TechBatch/Ad-Hoc-Network-Communication-System-for-Disaster-Relief/POSTER/TECHBatchjpg.jpg

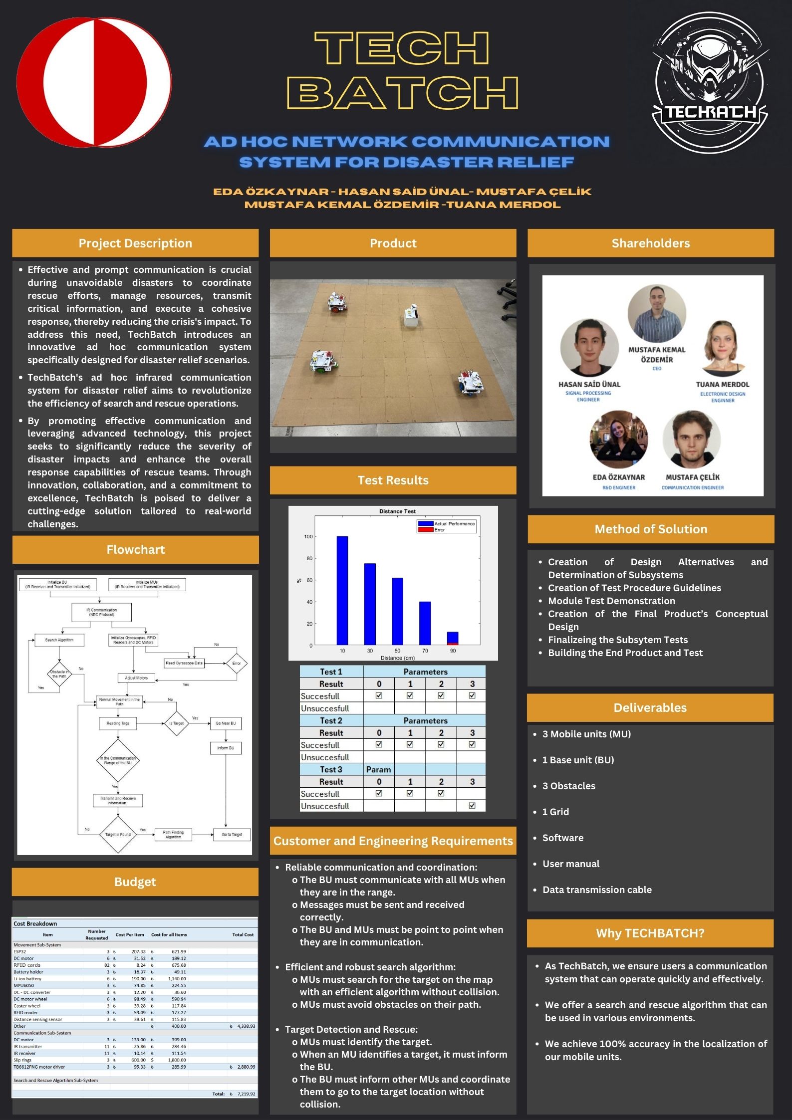
POSTER/TECHBatchjpg.jpg
