TechBatch/Ad-Hoc-Network-Communication-System-for-Disaster-Relief/README.md

# Ad-Hoc-Network-Communication-System-for-Disaster-Relief
TechBatch 2023-24 Capstone Project
