TechBatch/Ad-Hoc-Network-Communication-System-for-Disaster-Relief/Flowcharts of Algorithms/README.md

# Ad-Hoc-Network-Communication-System-for-Disaster-Relief
# Flowcharts of Algorithms
TechBatch 2023-24 Capstone Project
## Link for search algorithm flowchart
https://app.diagrams.net/#G1cPadi86MyawuQ8vJ1zWhPavOyXc6iH4G
  ### TO DO:
  * Add other MU's target info according to code architecture algorithm.
## Link for Grid partitioning
https://app.diagrams.net/#G1-ycmmlxIB4yDz8SyxYrDLsC9prfCw-PL
