TechBatch/Ad-Hoc-Network-Communication-System-for-Disaster-Relief/Presentation/metu_eee_presentation_template.pptx

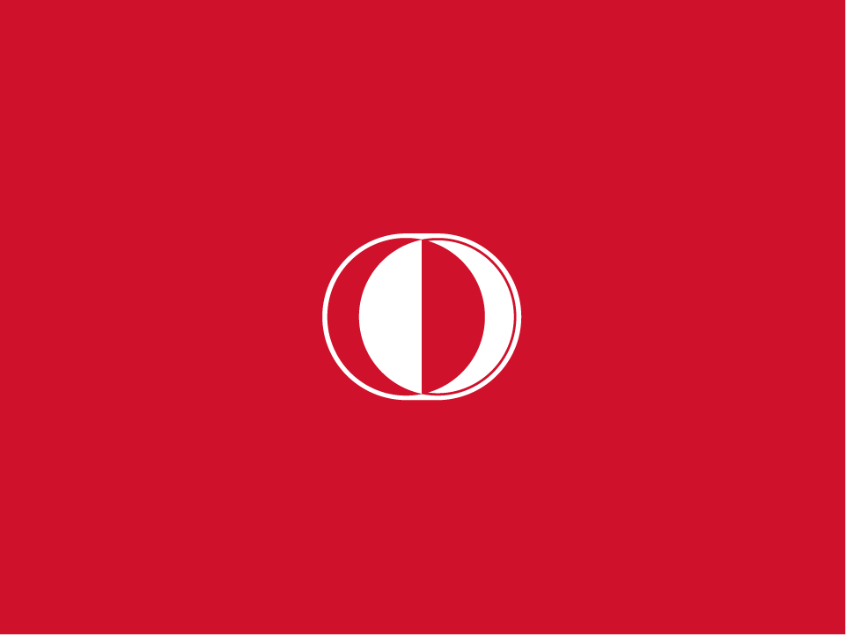
[picture p23: figure]

## Slide 2

## Slide 3

## Slide 4

## Slide 5
