TechBatch/Ad-Hoc-Network-Communication-System-for-Disaster-Relief/POSTER/TECHBatchstdpdf.pdf

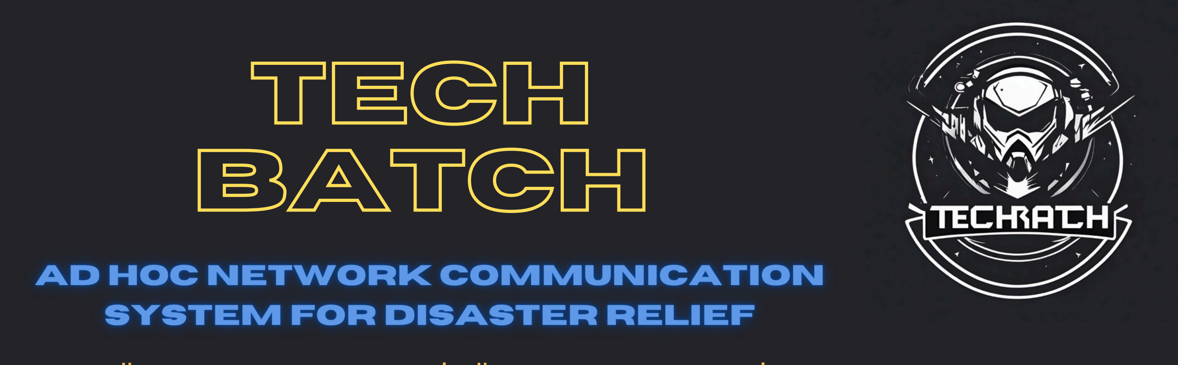
[picture p33: figure]
TECH BATCH

Project Description | Product | Shareholders


### Method of Solution Flowchart


### Budget


### Why TECHBATCH?


### Deliverables

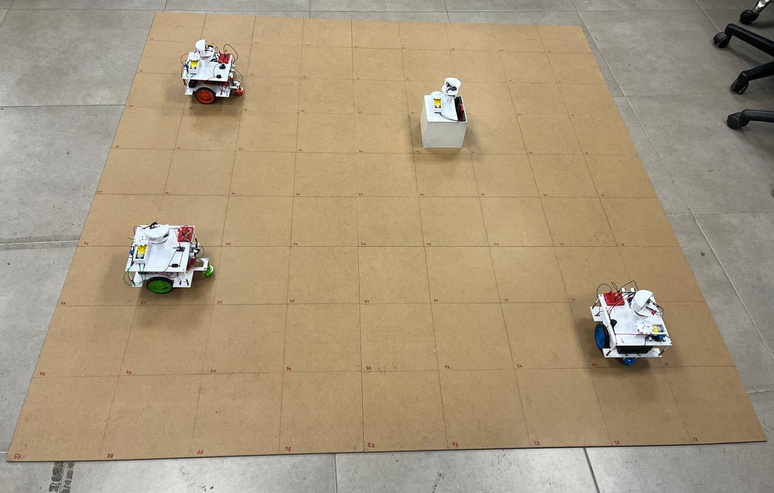
[picture p34: figure]

### Test Results

Customer and Engineering Requirements; Reliable communication and coordination:; they are in the range. o Messages must be sent and received correctly.; they are in communication.; Efficient and robust search algorithm:; Target Detection and Rescue: o MUs must identify the target.; the BU.; collision.

o The BU must communicate with all MUs when

o The BU and MUs must be point to point when

o MUs must search for the target on the map with an efficient algorithm without collision. o MUs must avoid obstacles on their path.

o When an MU identifies a target, it must inform

o The BU must inform other MUs and coordinate them to go to the target location without

EDA ÖZKAYNAR - HASAN SAİD ÜNAL- MUSTAFA ÇELİk mustafa kemal özdemİr -tuanamerdol

Creation | of | Design | Alternatives | and
Determination of Subsystems
Creation of Test Procedure Guidelines
Module Test Demonstration
Creation of the Final Product’s Conceptual Design
Finalizeing the Subsytem Tests
Building the End Product and Test

Effective and prompt communication is crucial during unavoidable disasters to coordinate rescue efforts, manage resources, transmit critical information, and execute a cohesive response, thereby reducing the crisis's impact. To address this need, TechBatch introduces an innovative ad hoc communication system specifically designed for disaster relief scenarios. TechBatch's ad hoc infrared communication system for disaster relief aims to revolutionize the efficiency of search and rescue operations. By promoting effective communication and leveraging advanced technology, this project seeks to significantly reduce the severity of disaster impacts and enhance the overall response capabilities of rescue teams. Through innovation, collaboration, and a commitment to excellence, TechBatch is poised to deliver a cutting-edge solution tailored to real-world challenges.

### 3 Mobile units (MU)

### 1 Base unit (BU)

### 3 Obstacles

### 1 Grid

Software

User manual

Data transmission cable

As TechBatch, we ensure users a communication system that can operate quickly and effectively.

We offer a search and rescue algorithm that can be used in various environments.

We achieve 100% accuracy in the localization of our mobile units.
