TechBatch/Ad-Hoc-Network-Communication-System-for-Disaster-Relief/Flowcharts of Algorithms/code_arcitecture.jpg

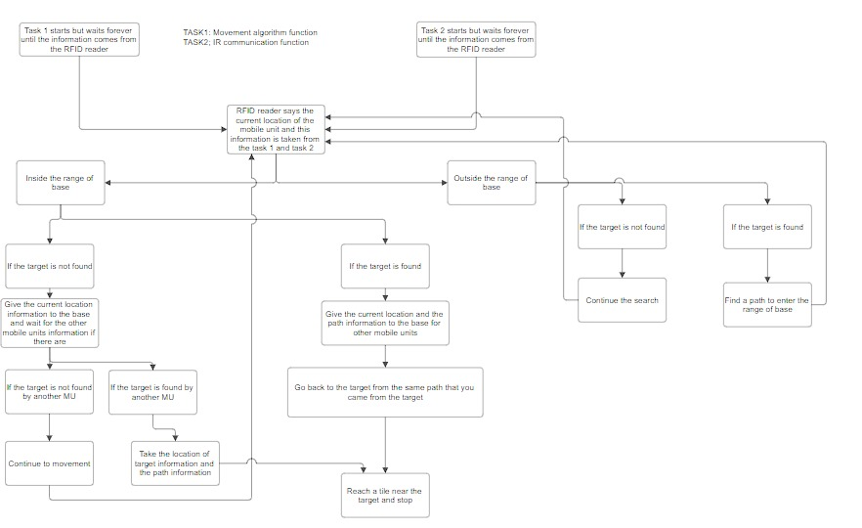
Flowcharts of Algorithms/code_arcitecture.jpg
