TechBatch/Ad-Hoc-Network-Communication-System-for-Disaster-Relief/Flowcharts of Algorithms/SearchAlgorithm.png

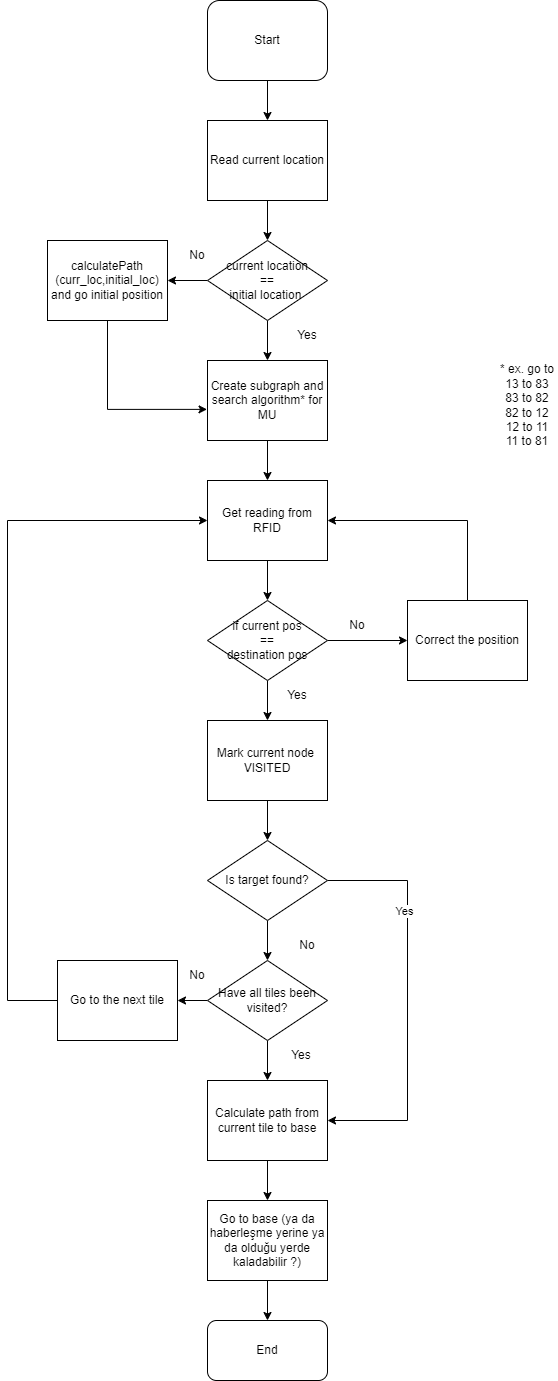
Flowcharts of Algorithms/SearchAlgorithm.png
