TechBatch/Ad-Hoc-Network-Communication-System-for-Disaster-Relief/Flowcharts of Algorithms/SearchAlgorithmFlowChart.png

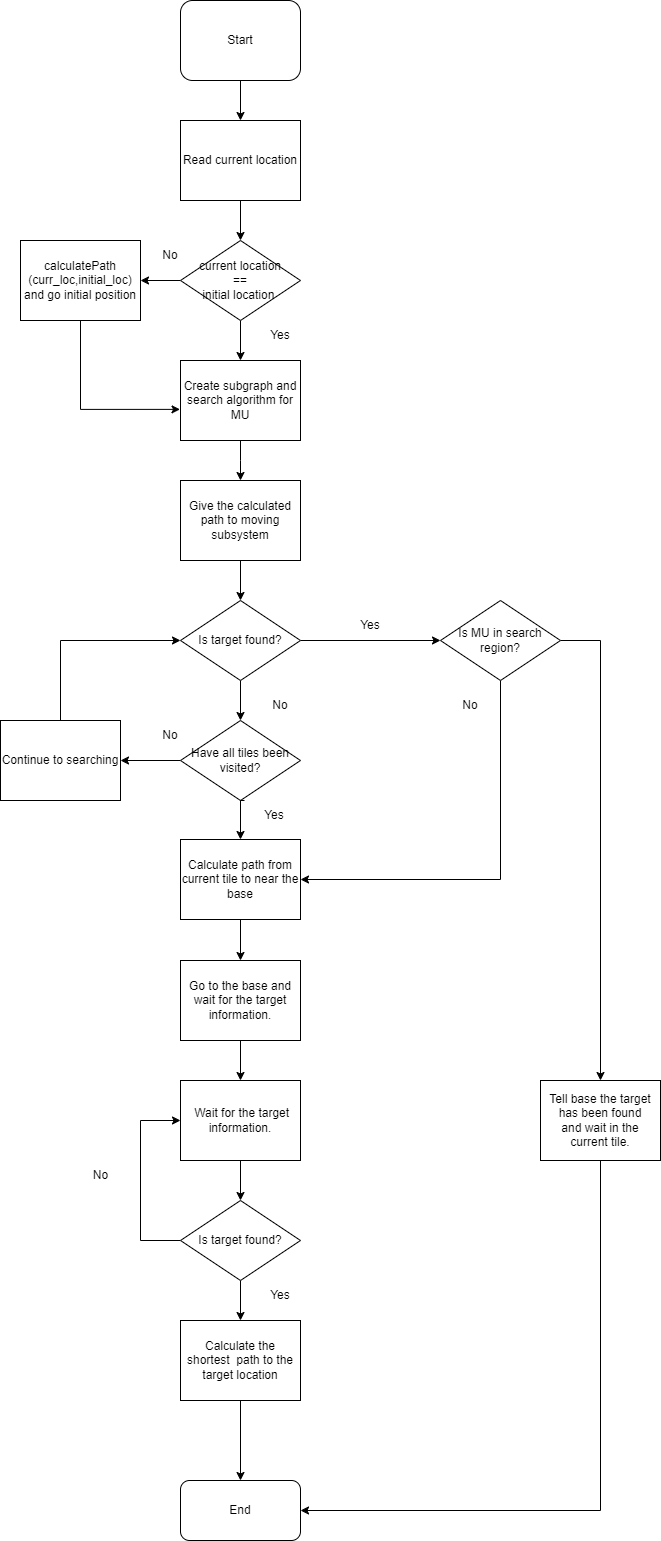
Flowcharts of Algorithms/SearchAlgorithmFlowChart.png
