TechBatch/Ad-Hoc-Network-Communication-System-for-Disaster-Relief/Flowcharts of Algorithms/SearchinInSubgrid.png

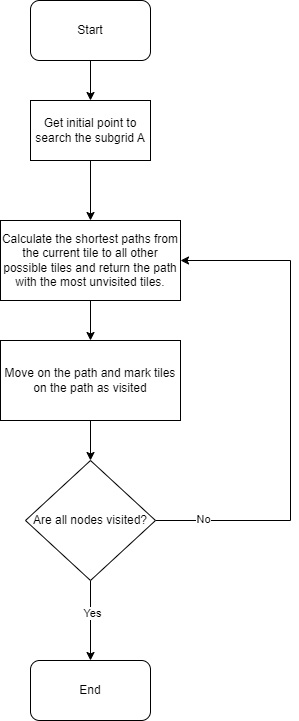
Flowcharts of Algorithms/SearchinInSubgrid.png
