TechBatch/Ad-Hoc-Network-Communication-System-for-Disaster-Relief/Presentation/Copy of Grid (6) (1).gif

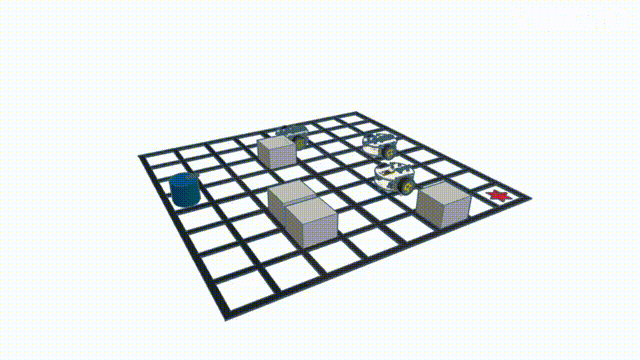
Presentation/Copy of Grid (6) (1).gif
