TechBatch/Ad-Hoc-Network-Communication-System-for-Disaster-Relief/Presentation/Copy of Grid (7).png

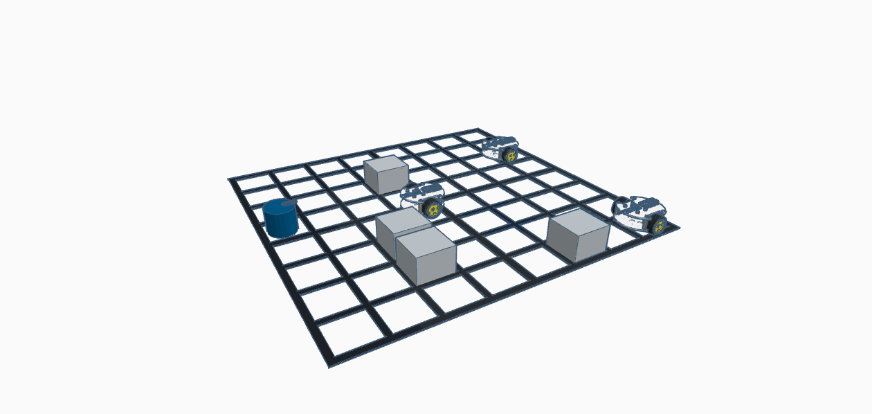
Presentation/Copy of Grid (7).png
