TechBatch/Ad-Hoc-Network-Communication-System-for-Disaster-Relief/Presentation/Copy of Grid (12).png

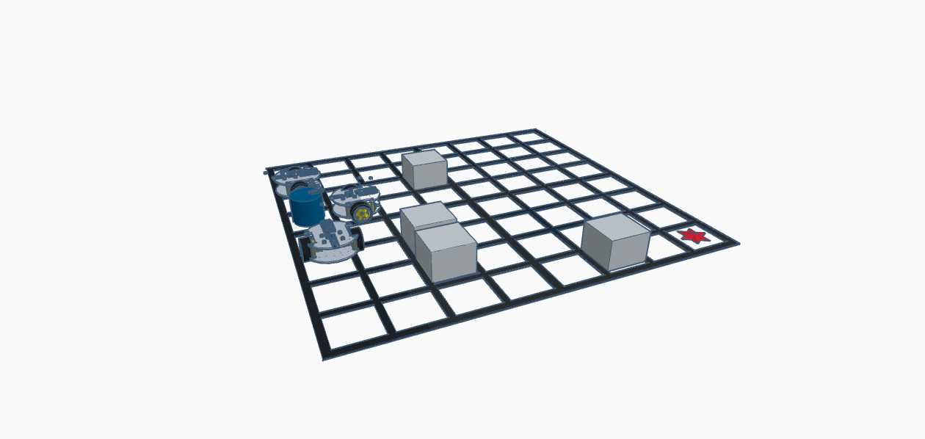
Presentation/Copy of Grid (12).png
