TechBatch/Ad-Hoc-Network-Communication-System-for-Disaster-Relief/LOGBOOKS/EO_logbook/Eda_Ozkaynar_LOGBOOK.md

# Ad-Hoc-Network-Communication-System-for-Disaster-Relief
Eda Özkaynar's LogBook

## Week 1  

First week of the semester. Meeting with DS coordinator.

## Week 2 Feb. 26-Mar. 3

* I started to code the search and rescue algorithm in C++.
* I created a new repository for the algorithm and updated my progress in the readme file in the repository. https://github.com/eozkaynar/Search-and-Rescue-Algorithm

    ### The progress in the code is :

        *Done:* 

        * Graph structure is created.
        * Grid is created.
        * Neighbors vector is added.
        * Tile status change function added.

        *TO DO:*

        * Add setWeight vector.
        * Add an enum class for Base and target tiles.
        * Grid partitioning.
        * Partition search for one mu.
        * Dijkstra's algorithm.

* I also created a new organization in GitHub to share all codes  and documents with team members.

* To design our mobile unit and print it from a 3D printer, I search some Fusion360 tutorials 
   - https://www.youtube.com/watch?v=0UwskVYpIMs&list=PL71VJFXzv0pC7JpAIicORX099_l8vVdD7&index=55 

   - https://www.youtube.com/watch?v=whG6UViyYC8&list=PL6LZsmCI3cyBWlLTHuKvucd95NfqovyZN 

    and Solidworks tutorials
    - https://www.youtube.com/watch?v=KLFIOC1Mw2A&list=PL-QEs5hXmxkpKlx30RxpzIAozZgyJkuZU&index=11

    - https://www.youtube.com/watch?v=aPjONdduElw&list=PLEWDbWMyVbuq8gc9yPNDeYrzjyZwL62DU

## Week 3 Mar. 4-10
