TechBatch/Ad-Hoc-Network-Communication-System-for-Disaster-Relief/LOGBOOKS/MC_logbook/_LOGBOOK.md

# Ad-Hoc-Network-Communication-System-for-Disaster-Relief
Mustafa's LogBook

## Week 1  

First week of the semester. Meeting with DS coordinator.

## Week 2 Feb. 26-Mar. 3

## Week Mar. 4-10
