TechBatch/Ad-Hoc-Network-Communication-System-for-Disaster-Relief/Grid.pdf

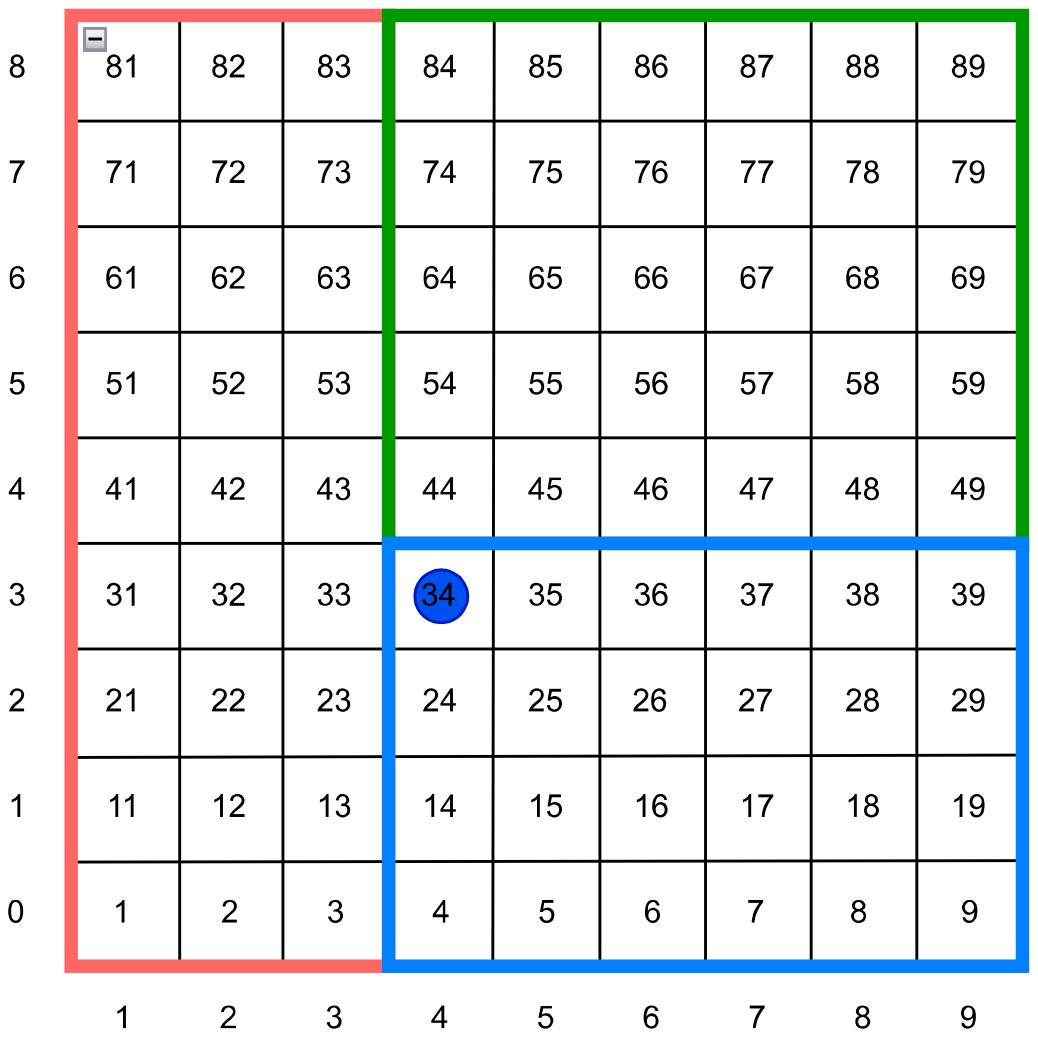
[picture p60: page 1]
