TechBatch/Ad-Hoc-Network-Communication-System-for-Disaster-Relief/Codes/Ad-Hoc Network Communication System for Disaster Relief/MU1/MU1Header.h

#include <stdlib.h>
#include <stdio.h>
#include <math.h>
#include <string.h>


/**************************************************/
#define DECODE_NEC
#define CUSTOM_SETTINGS
#define INCLUDE_TERMINAL_MODULE
/**************************************************/
/*********************LIB*************************/
#include <IRremote.hpp>
#include <Arduino.h>
#include <SPI.h>
#include <MFRC522.h>
#include "I2Cdev.h"
#include <Wire.h>
#include <TB6612_ESP32.h>
#include <iostream>
#include <algorithm>
#include <queue>
#include <stack>
#include <climits>
#include "grid.h"
#include "grid_functions.h"
#include "MPU6050_6Axis_MotionApps20.h"

#if I2CDEV_IMPLEMENTATION == I2CDEV_ARDUINO_WIRE
    #include "Wire.h"
#endif

//define sound speed in cm/uS
#define SOUND_SPEED 0.034
#define CM_TO_INCH 0.393701

/*************************************************/
/*******************HEADERS********************/

#define BU_NAME                 0x1

#define MU1_NAME                0x2
#define MU2_NAME                0x3
#define MU3_NAME                0x4                 

/*************************************************/
/*******************BASE MSGS********************/

#define BU_MSG_RECEIVED_MU1     0x1
#define BU_MSG_RECEIVED_MU2     0x2
#define BU_MSG_RECEIVED_MU3     0x3
#define BU_MSG_NOT_RECEIVED     0x0

#define BU_TALK_MU1             MU1_NAME
#define BU_TALK_MU2             MU2_NAME
#define BU_TALK_MU3             MU3_NAME
#define BU_AVAILABLE            0xF
#define BU_CLOSE                0xC

#define FIRST                   0x1
#define SECOND                  0x2
#define THIRD                   0x3
#define INIT                    0x0

#define MU1_FOUND               0x1
#define MU2_FOUND               0x2
#define MU3_FOUND               0x3
#define NF                      0x0

/*************************************************/
/*******************MU MSGS**********************/

#define MU_MSG_RECEIVED         0x1
#define MU_MSG_NOT_RECEIVED     0x2

#define MU_TARGET_FOUND         0x1
#define MU_TARGET_NOT_FOUND     0x2

/*************************************************/
/***********TILE IDS*************/
#define UNKNOWN     0x77
#define TARGET      0x64

#define TILE_A1     0x01
#define TILE_A2     0x02
#define TILE_A3     0x03
#define TILE_A4     0x04
#define TILE_A5     0x05
#define TILE_A6     0x06
#define TILE_A7     0x07
#define TILE_A8     0x08
#define TILE_A9     0x09

#define TILE_B1     0x0B
#define TILE_B2     0x0C
#define TILE_B3     0x0D
#define TILE_B4     0x0E
#define TILE_B5     0x0F
#define TILE_B6     0x10
#define TILE_B7     0x11
#define TILE_B8     0x12
#define TILE_B9     0x13

#define TILE_C1     0x15
#define TILE_C2     0x16
#define TILE_C3     0x17
#define TILE_C4     0x18
#define TILE_C5     0x19
#define TILE_C6     0x1A
#define TILE_C7     0x1B
#define TILE_C8     0x1C
#define TILE_C9     0x1D

#define TILE_D1     0x1F
#define TILE_D2     0x20
#define TILE_D3     0x21
#define TILE_D4     0x22
#define TILE_D5     0x23
#define TILE_D6     0x24
#define TILE_D7     0x25
#define TILE_D8     0x26
#define TILE_D9     0x27

#define TILE_E1     0x29
#define TILE_E2     0x2A
#define TILE_E3     0x2B
#define TILE_E4     0x2C
#define TILE_E5     0x2D
#define TILE_E6     0x2E
#define TILE_E7     0x2F
#define TILE_E8     0x30
#define TILE_E9     0x31

#define TILE_F1     0x33
#define TILE_F2     0x34
#define TILE_F3     0x35
#define TILE_F4     0x36
#define TILE_F5     0x37
#define TILE_F6     0x38
#define TILE_F7     0x39
#define TILE_F8     0x3A
#define TILE_F9     0x3B

#define TILE_G1     0x3D
#define TILE_G2     0x3E
#define TILE_G3     0x3F
#define TILE_G4     0x40
#define TILE_G5     0x41
#define TILE_G6     0x42
#define TILE_G7     0x43
#define TILE_G8     0x44
#define TILE_G9     0x45

#define TILE_H1     0x47
#define TILE_H2     0x48
#define TILE_H3     0x49
#define TILE_H4     0x4A
#define TILE_H5     0x4B
#define TILE_H6     0x4C
#define TILE_H7     0x4D
#define TILE_H8     0x4E
#define TILE_H9     0x4F

#define TILE_I1     0x51
#define TILE_I2     0x52
#define TILE_I3     0x53
#define TILE_I4     0x54
#define TILE_I5     0x55
#define TILE_I6     0x56
#define TILE_I7     0x57
#define TILE_I8     0x58
#define TILE_I9     0x59

/*************************************************/
/***************DISTANCE SENSOR*******************/

#define SOUND_SPEED     0.034
#define CM_TO_INCH      0.393701

/*************************************************/
/***********************GYRO**********************/

#define OUTPUT_READABLE_YAWPITCHROLL
#define OUTPUT_READABLE_REALACCEL

/*************************************************/
/***************COMMUNICATION PINS****************/

#define MU_TRANSMITTER         32 
#define MU_RECEIVER            27

/*************************************************/
/*******************MOTOR PINS********************/

/*************************************************/
/*******************RFID PINS*********************/

#define SS_PIN                  5
#define RST_PIN                 0

/*************************************************/
/***************DISTANCE SENSOR*******************/

 // 16 to 34

/*************************************************/
/***********************GYRO**********************/

#define INTERRUPT_PIN     35 // 2 to 35 

#define red           2
#define yellow        16
/*************************************************/
/*****************MOTOR DRIVER********************/

#define AIN1 13 // ESP32 Pin D13 to TB6612FNG Pin AIN1
#define BIN1 12 // ESP32 Pin D12 to TB6612FNG Pin BIN1
#define AIN2 4 // ESP32 Pin D14 to TB6612FNG Pin AIN2
#define BIN2 26 // ESP32 Pin D27 to TB6612FNG Pin BIN2
#define PWMA 15 // ESP32 Pin D26 to TB6612FNG Pin PWMA
#define PWMB 25 // ESP32 Pin D25 to TB6612FNG Pin PWMB
#define STBY 33 // ESP32 Pin D33 to TB6612FNG Pin STBY

/*************************************************/
/*******************STRUCTS*********************/


typedef struct MU_STRUCT
{   
  unsigned int uiMUHeader = MU1_NAME;
  unsigned int uiMUReceivement = MU_MSG_NOT_RECEIVED;
  unsigned int uiMUFinding = MU_TARGET_NOT_FOUND;
  unsigned int uiMUCurrentLocation = UNKNOWN;
  unsigned int uiMUTargetLocation = UNKNOWN;  //EDA SENİN FONKSİYONUNUN İNPUTLARINDAN BİRİ BU mu.uiMUTargetLocation: Target Location
                                              //FoundInfo : Kim buldu targeti
                                              //QueueID: Base'in atatdığı sıra

}MU;

typedef struct BU_STRUCT
{
  unsigned int uiBUHeader = BU_NAME;
  unsigned int uiBUReceivement = BU_MSG_NOT_RECEIVED;
  unsigned int uiBUTalk = BU_CLOSE;
  unsigned int uiBUWhoFound = NF; 
  unsigned int uiBUQueue = INIT;
  unsigned int uiBUTargetLocation = UNKNOWN;

}BU;


/*********************************/

/**************COMMUNICATION FUNC DEF*****************/
unsigned int createMessageMU(unsigned int uiHeader, unsigned int uiReceivement, unsigned int uiFinding, unsigned int uiCurrentLocation, unsigned int uiTargetLocation);
void parseMessageMU(unsigned int message); //MU parses the message coming from BU
int checkDecode(unsigned int rawdata);
int checkHeader(BU* bu);
void setFinding(MU* mu);
int checkReceivement(BU* bu, MU* mu);
void setReceivement (MU* mu);
int checkTalk(BU* bu);
void learnTargetLocation(MU* mu, BU* bu);
void getWhoFound(BU* bu);
/**************GYRO FUNC DEF*************/
void dmpDataReady(void);

/**************RFID FUNC DEF*************/
int encodeRFID(byte *buffer);

/************MOTOR FUNC DEF**************/
void PID_forward(void);
void PID_backward(void);
void rotate (void);
void rotate_degree(float target_correction);
int error_in_path(int base_loc);
void reset_global_var(void);
int check_closest_tile(int sub_tile,int loc);
void not_finding_any_card(void);
void rotate_degree(float target_correction);
int check_corner(int base_loc);
int encode_cross_direction(int c, int p0, int p1);
int encode_direction(int last_loc,int current_loc, int old_diff);
/*************TASKS DEF************/
void taskSendMessage(void *pvParameters);
void taskReceiveMessage(void *pvParameters);
