TechBatch/Ad-Hoc-Network-Communication-System-for-Disaster-Relief/(commit log)

2024-03-06 New file Flowcharts of Algorithms is added.
2024-03-10 Flowchart of Search in Subgrid algorithm is added.
2024-03-30 BU ve MU kodlandı, Current Location bilgisi için RFID kodu MU ya eklendi. Derlendi test edilecek
2024-03-30 encodeRFID fonksiyonuna yeni tile kodları eklendi.
2024-03-30 Search algorithm flowchart is added.
2024-04-24 communication codes are updated and assembled with movement codes
2024-05-27 HOCALAR DEMOSU KODU DÜZENLİ
    QueueID ataması probleminin kaynağı anlaşıldı gibi
    [BU.ino, MU1.ino, MU1Header.h, MU2.ino, MU2Header.h, MU3.ino, MU3Header.h, grid.h]
